Psavvas/InfantGuard/V3ArduinoSchematic.png

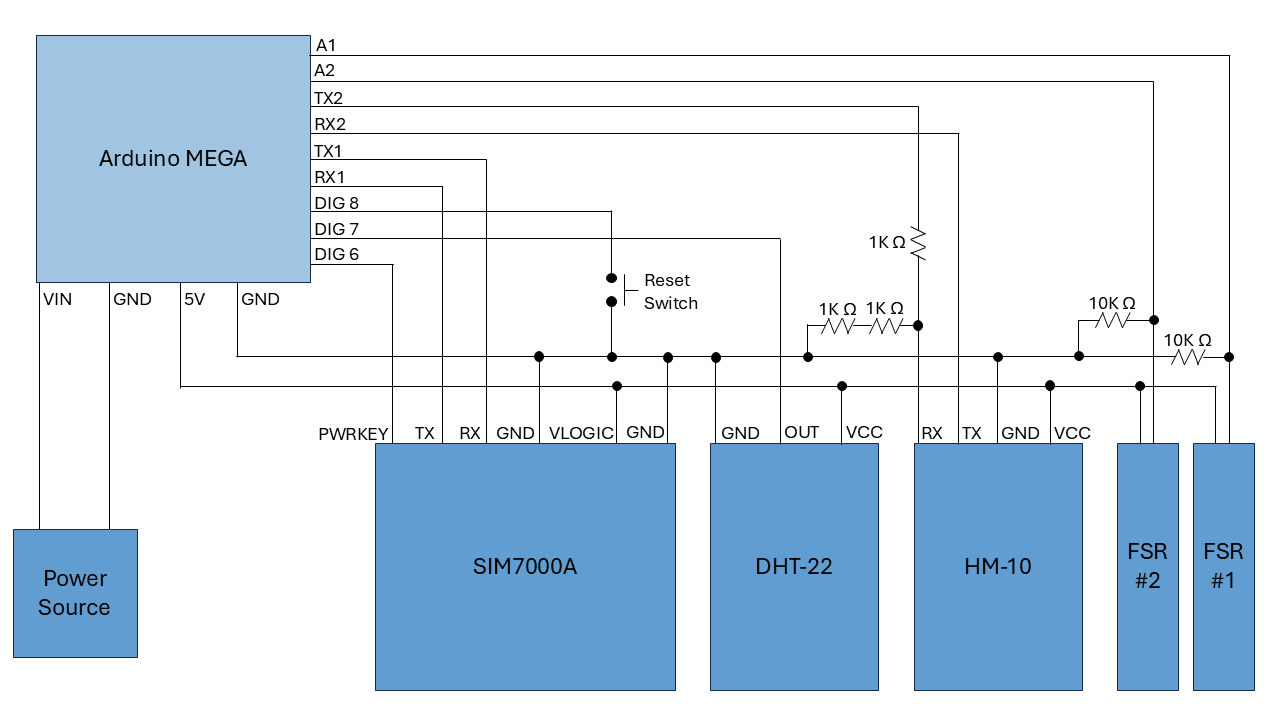
V3ArduinoSchematic.png
