Psavvas/InfantGuard/arduino.ino

#include "DHT.h"
#include "BotleticsSIM7000.h"
#define SIMCOM_7000
#define BOTLETICS_PWRKEY 6

// Define Sensor Pins
#define FSR_PIN1 A1
#define FSR_PIN2 A2
#define DHT_PIN 7
#define DHT_TYPE DHT22
const int buttonPin = 2;  // Pushbutton pin is in digital 2, which allows interupt capability
DHT dht(DHT_PIN, DHT_TYPE);  

// Global Variables
const int childThreshold = 500; // Update FSR value that determines infant is present
const int nearDeadlyTemp = 90; // Update temperature value that determines near deadly temperature
const int deadlyTemp = 95; // Update temperature value that determines  deadly temperature
bool parentPresent = false;
unsigned long lastParentTextTime = 90000;
unsigned long last911TextTime = 900000;
volatile bool buttonPressed = false;

//Device ID
const char* DEVICE_ID = "001";

//SMS Variables
char URL[256];
char cord1_buf[16];
char cord2_buf[16];
char temp_buf[16];
char data[80];
uint16_t statuscode;
uint16_t length;

//Shield Variables
#define MODEM_SERIAL Serial1   // TX1=18, RX1=19
Botletics_modem_LTE modem = Botletics_modem_LTE(); // Instantiate modem LTE class
const uint8_t modem_PWRKEY = 6; // for botletics SIM7000 shield

//HM-10 Bluetooth Variables
#define BT Serial2   // TX2=16, RX2=17
const char* MAC_Address = "DD88000011EE";

void setup() 
{
  Serial.begin(9600);
  modem.powerOn(modem_PWRKEY); // Power on the module
  shieldSetUp(); //SIM7000A Shield Setup
  dht.begin();
  bluetoothSetup(); //HM-10 Bluetooth Setup
  delay(1000);
  pinMode(buttonPin, INPUT_PULLUP);
  attachInterrupt(digitalPinToInterrupt(buttonPin), buttonStatus, FALLING); // Sets up interrupt on button pin

  //Startup Notification
  Serial.println("System Active");
  textCloudflare(0, 0.0, 0.0, "stat", DEVICE_ID);

}

void loop() 
{
  int fsrValue1 = analogRead(FSR_PIN1); //Reads and stores first FSR value
  int fsrValue2 = analogRead(FSR_PIN2); //Reads and stores second FSR value
  float temp = dht.readTemperature(true); // Reads and stores FSR value in farenhite
  Serial.println(fsrValue1);
  Serial.println(fsrValue2);
  Serial.println(temp);
  scanDevices();

  // Activates sytem if child is detected
  if (fsrValue1 >= childThreshold || fsrValue2 >= childThreshold) 
  {
    //Get GPS Coordinates
    Serial.println("Child Detected");
    float cord1, cord2, speed_kph, heading, altitude;
    modem.getGPS(&cord1, &cord2, &speed_kph, &heading, &altitude);
    Serial.println(parentPresent);
    if (temp >= deadlyTemp && !parentPresent)
    {
      //Take Action to notify parent and call 911
      if (millis() - last911TextTime > 900000) 
      { 
        // Sends 911 text only once every 15 minutes
        Serial.println("Sending Emergency Text to 911");
        textCloudflare(temp, cord1, cord2, "emg", DEVICE_ID);
        last911TextTime = millis();
        Serial.println("911 Text Sent");
      }
      if (millis() - lastParentTextTime > 90000) 
      { 
        // Sends parent text only once every 90 seconds
        Serial.println("Sending Emergency Text to parent");
        textCloudflare(temp, cord1, cord2, "gen", DEVICE_ID);
        lastParentTextTime = millis();
        Serial.println("Parent Text Sent");
      }
      Serial.println("Detected infant and deadly temperature");
    } else if (!parentPresent)
    {
      if (millis() - lastParentTextTime > 90000) 
      { 
        // Sends parent text only once every 90 seconds
        Serial.println("Sending General Text to parent");
        textCloudflare(temp, cord1, cord2, "gen", DEVICE_ID);
        lastParentTextTime = millis();
        Serial.println("Parent Text Sent");
      }
      Serial.println("Detected infant alone and non-deadly temperature");
    }
  }

  //Deactivation Button Check
  if (buttonPressed) 
  {
    buttonPressed = false; //Reset button pressed variable
    Serial.println("System disactivated for 15 minutes.");
    textCloudflare(1000, 0.0, 0.0, "stat", DEVICE_ID); //Sent deactivation text
    delay(900000); //15 minute delay
    textCloudflare(2000, 0.0, 0.0, "stat", DEVICE_ID); //Sent reactivation text
    Serial.println("System re-activated");
  }
}

void textCloudflare(float temp, float cord1, float cord2, const char* type, const char* deviceId)
{
  dtostrf(cord1, 1, 6, cord1_buf);
  dtostrf(cord2, 1, 6, cord2_buf);
  dtostrf(temp,  1, 1, temp_buf);
  snprintf(URL, sizeof(URL), "http://webhook.site/infantGrd/?cord1=%s&cord2=%s&temp=%s&type=%s&deviceId=%s", cord1_buf, cord2_buf, temp_buf, type, deviceId);
  
  // Try sending up to 2 times
  for (int attempt = 1; attempt <= 2; attempt++) {
    
    // Check if GPRS is active, if not, turn it on
    if (!modem.GPRSstate()) {
      Serial.println("GPRS inactive.");
      modem.enableGPRS(true);
      delay(3000); // Wait for the network to assign an IP
    }

    Serial.print("HTTP GET Attempt ");
    Serial.println(attempt);
    
    modem.HTTP_GET_start(URL, &statuscode, &length);
    modem.HTTP_GET_end();

    if (statuscode == 200) {
      Serial.println("HTTP Success! (200)");
      break; // Break out of the retry loop if connection worked.
    } else {
      Serial.print("HTTP Failed. Code: ");
      Serial.println(statuscode);
      
      // Force a network reset if a 601 error occured
      if (statuscode == 601) {
        Serial.println("Forcing GPRS reset");
        modem.enableGPRS(false); // Turn GPRS off
        delay(2000);
        modem.enableGPRS(true);  // Turn GPRS back on
        delay(3000);
      }
    }
  }
}

void shieldSetUp()
{
  //Setup code for the SIM7000A Shield
  MODEM_SERIAL.begin(115200);
  delay(1000);
  MODEM_SERIAL.println("AT+IPR=9600"); // Manually set baud rate regardless of whether or not modem is actually on 115200
  delay(100); // Short pause to let the command run
  MODEM_SERIAL.begin(9600);
  modem.begin(MODEM_SERIAL);
  modem.setFunctionality(1); // AT+CFUN=1
  modem.setNetworkSettings(F("hologram")); // For Hologram SIM card
  modem.openWirelessConnection(true); // Enable connection
  modem.enableGPRS(true); // Enable GPRS
  modem.enableGPS(true); // Enable GPS
  delay(10000);
}

void bluetoothSetup()
{
  //HM-10 Bluetooth Setup
  BT.begin(9600);
  delay(1500);
  sendCommand("AT");          // establishes connection
  sendCommand("ATE0");      // disable echo
  sendCommand("AT+IMME1");    // manual connection
  sendCommand("AT+ROLE1");    // sets device as a scanner
  sendCommand("AT+NOTI1");    // enables notifications
}

void sendCommand(const char* cmd) 
{
  unsigned long start = millis(); //gets start time
  String response = ""; //blank string for response

  Serial.print("CMD: "); //prints command
  Serial.println(cmd);  // prints command
  BT.print(cmd); //sends command to module

  //parses all the data recived for 0.5 seconds
  while (millis() - start < 3000) 
  {
    while (BT.available()) 
    {
      response += (char)BT.read();
    }
  }

  //prints response
  Serial.print("RESP: ");
  Serial.println(response);
}

void scanDevices() 
{
  int falseParent = 0; //counts number of times parent device is not found or out of range
  for(int i = 0; i < 5; i++) 
  {
    unsigned long start = millis(); //gets start time
    String response = ""; //makes blank response string

    Serial.print("CMD: AT+DISI?");
    BT.print("AT+DISI?"); //sends command to module

    //parses all the data received for 5 seconds
    while (millis() - start < 5000) 
    {
      while (BT.available()) 
      {
        response += (char)BT.read();
      }
    }

    //prints response
    Serial.print("RESP: ");
    Serial.println(response);

    //Check if parent device is found and within range
    int index = response.indexOf(MAC_Address);
    if (index != -1) 
    {
      int RSSI = response.substring(index + 13, index + 17).toInt();
      if(RSSI <= -80) 
      { //Check if RSSI is weak enough to be considered "out of range"
        falseParent += 1;
        Serial.println("BLE out of Range");
      }
    } else {
      falseParent += 1;
      Serial.println("BLE not found");
    }
  }

  if (falseParent >= 4) 
  { 
    //If parent device is not found or out of range 4 or more times, consider parent not present
    parentPresent = false;
  } else {
    parentPresent = true;
  }
  
  Serial.print("----------------\nParent present: ");
  Serial.println(parentPresent ? "YES" : "NO");
}

void buttonStatus() 
{
  // Attach Interrupt function for button press
  Serial.println("=========== Button Pressed ===========");
  buttonPressed = true; // Set buttonPressed to true if button is pressed at any time
}
