Psavvas/InfantGuard/(commit log)

2025-11-15 Refactor SMS handling and add GPS functionality in arduino.c++
2025-11-19 Enhance SIM7000A shield setup with improved baud rate configuration and enable GPRS functionality. THis code currently works.
2025-11-23 Refactor Bluetooth device scanning logic and improve command handling
2025-11-28 Modified Arduino Sketch code to utilize Hardware Serial ports on Arduino Mega instead of Software Serial allowing for better functionality.
2025-11-29 V1 of InfantGuard Code on Arduino Mega
2025-11-30 Added Arduino Circuit Schematic
2025-12-02 Add status messages for system disarm and reactivation in Cloudflare.js and arduino.cpp
2025-12-03 Implement button interrupt for system deactivation and reactivation in arduino.cpp. Such feature allows button to work as intended.
2025-12-07 Update arduino.cpp
    Updated minor spelling mistake in code comment
2025-12-07 Fix typos in comments and function names in arduino.cpp. Also fixed slight logic error in Cloudflare.js in regards to the varriable toNumber. The following changes are to prepare for the merge of dev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
2025-12-07 Enhance parent device detection logic in scanDevices function to account for out-of-range scenarios
2025-12-07 Remove debug print statement for falseParent in scanDevices function
2025-12-07 Refactor FSR pin definitions and update loop logic to read from multiple FSR sensors for improved child detection
2025-12-10 Refactor FSR sensor definitions and update loop logic to read from a single FSR sensor for child detection
2025-12-16 InfantGuard v3.0.0 - Improved FSR Support & Code Documentation (#13)
    * Fix spelling errors in emergency alert messages
    Corrected spelling of 'temporairly' to 'temporarily' in emergency messages.
    * Update RSSI threshold and false parent detection criteria in scanDevices function
    * Delete CircuitSchematic.png
    * Add files via upload
    * Rename V3 Arduino Schematic.png to CircuitSchematic.png
    * Delete CircuitSchematic.png
    * Add files via upload
    * Rename V3 Arduino Schematic.png to CircuitSchematic.png
    * Delete CircuitSchematic.png
    * Add files via upload
    * Enhance README with project details and features
    Expanded the README.md to include detailed background, features, hardware specifica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
2026-01-06 Add shutdown.cpp for SIM7000A modem setup
    Added shutdown program to allow for SIM7000A to correctly shut-down when power to the Arduino is cut.
2026-01-08 Rename V3 Arduino Schematic.png to V3ArduinoSchematic.png
2026-01-15 Update emergency notification logic to check for parent presence before alerting. Helped resolve edge-case bug. (#15)
2026-01-15 Replace flow chart image in README
    Updated image link for the InfantGuard General Code Flow.
2026-01-15 Update InfantGuard General Code Flow image link
    Updated the image link for the InfantGuard General Code Flow in the README.
2026-02-17 Update UI of Activation Site (#16)
    * Worked on increasingly project scalability by linking customer info (vehicle license plate, make, model, user phone number) to a database in Cloudflare, to allow for multiple InfantGuard devices to use the same webhook.site and Cloudflare worker.
    * Added a project website through Cloudflare Pages. Site now allows easy activation through dedicated form. Scalability was also improved with dedicated deviceId to hold importnat user info. This now permits multiple InfantGuard devices to use the same webhook.site URL. Activations site UI will continue to be improved in the coming weeks and modfied workers will be monitored for potential bugs/errors.
    * Small b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
    [arduino.ino, combinedTest.ino, shutdown.ino, testBluetooth.ino, testSMS.ino]
2026-02-18 Refactor Arduino code for clarity and structure
    Modified webhook.site URL and added deviceId for project scalability.
2026-02-18 Refactor Arduino code to improve readability and add DEVICE_ID parameter to textCloudflare function. Create settings.json for C/C++ configuration.
